Hylke44/LedCubeKit/README.md

# LedCubeKit
4x4x4 led cube driven by arduino nano

Build instructions can be found at https://frack.nl/wiki/Led_kubus_kit
