Hylke44/LedCubeKit/Casing/LedCubeKit_laser_casing.step

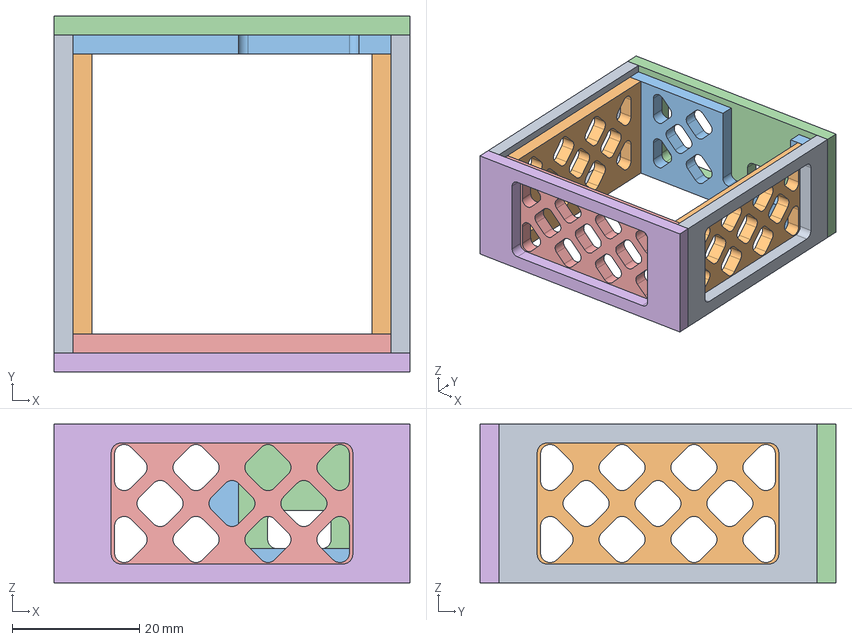
[picture p1: CAD file, 2017-01-14]
Casing/LedCubeKit_laser_casing.step
56.0 x 56.0 x 25.0 mm
LASER_CASING_P1
LASER_CASING_P2
LASER_CASING_P3
LASER_CASING_P4
LASER_CASING_P6
LASER_CASING_P5
LASER_CASING_P8
LASER_CASING_P7
