Hylke44/LedCubeKit/Casing/LedCubeKit_printed_casing.step

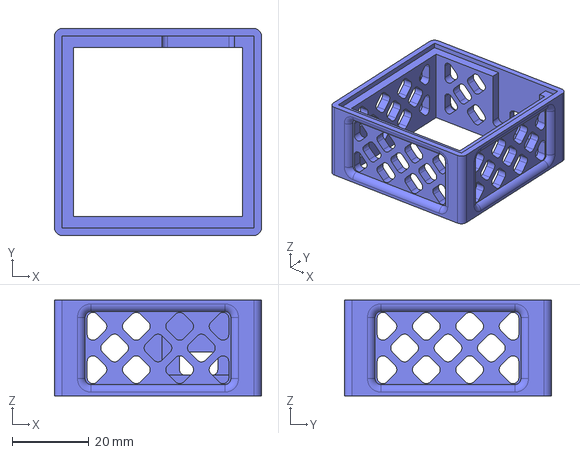
[picture p2: CAD file, 2017-01-14]
Casing/LedCubeKit_printed_casing.step
54.0 x 54.0 x 25.0 mm
