Hylke44/LedCubeKit/(list of files, cad)

Other CAD files:
Casing/LedCubeKit_milled_casing.step
Casing/LedCubeKit_Printed_Casing.stl
