Hylke44/LedCubeKit/PCB/LedCubeKit_PCB_Schematics.pdf

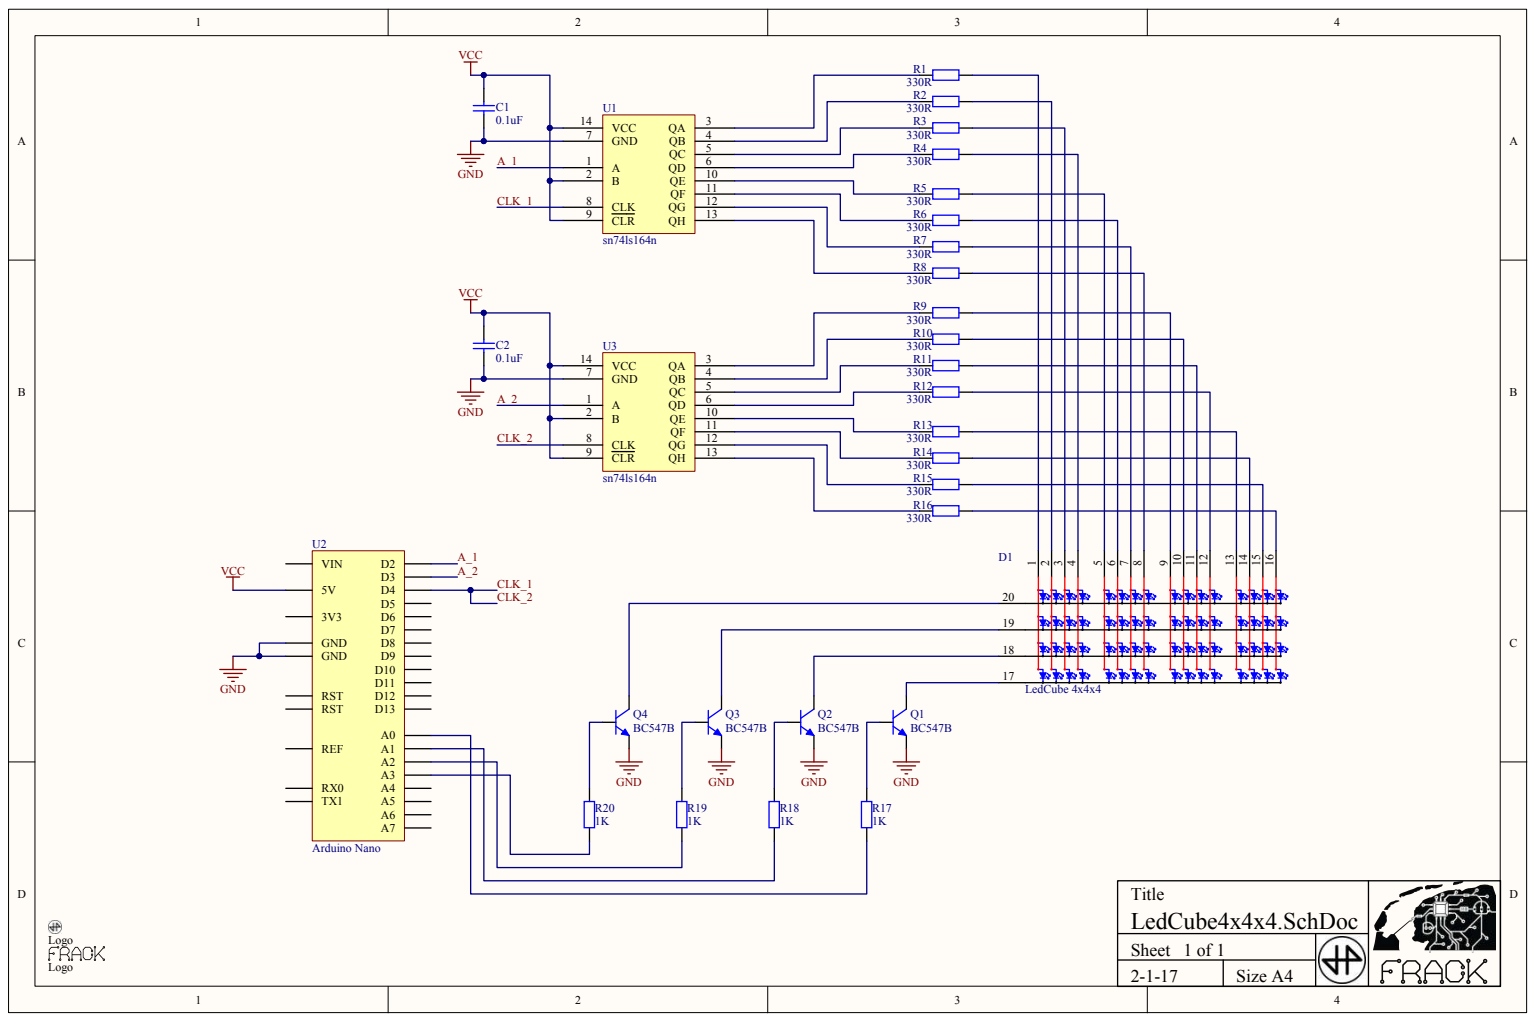
[picture p3: page 1]
