Hylke44/LedCubeKit/(commit log)

2017-02-16 Added firmware with basic spiral animation for the ledcube
2018-11-29 Improved code
    Moved led cube specific code to separate c and header file.
    Added more build-in led cube functions (turning on planes or lines, shifting the cube).
    More different animations as standard in the code
